thurask/btt_ups_24v_redux/btt_24v_ups_redux.kicad_pcb

## KiCad design btt_24v_ups_redux.kicad_pcb (2025-05-02)

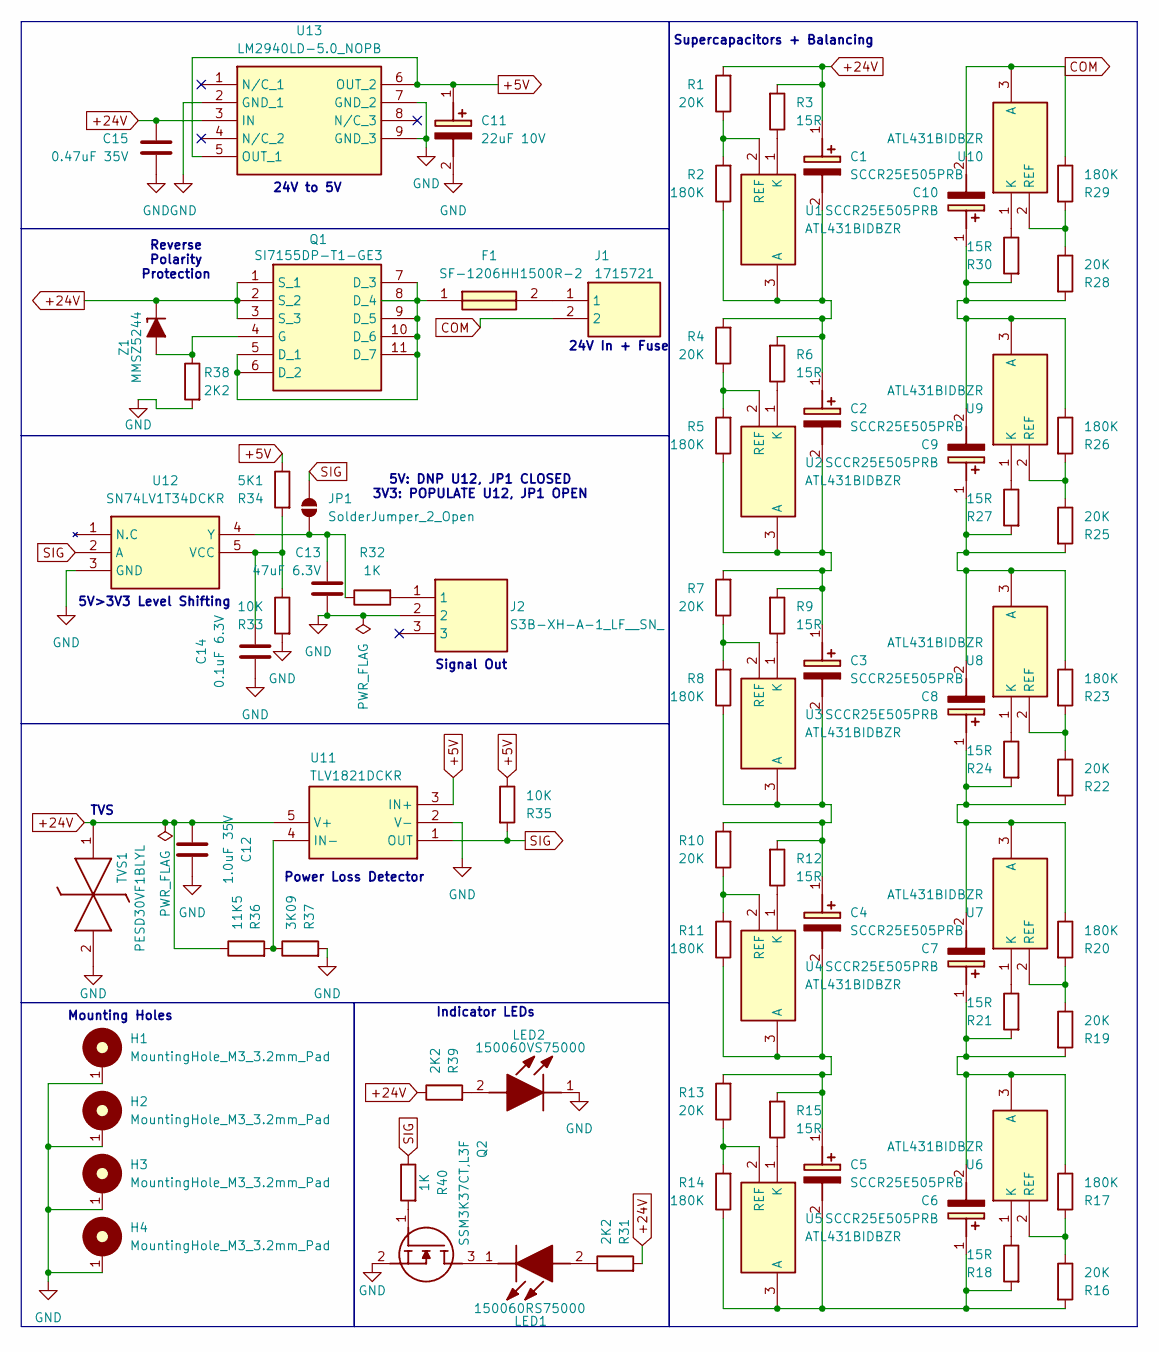
[picture p1: schematic btt_24v_ups_redux.kicad_sch]

Parts:
C1, C2, C3, C4, C5, C6, C7, C8, C9, C10: SCCR25E505PRB; CAPPRD350W65D800H2650; Mouser Part Number 581-SCCR25E505PRB
C11: 22uF 10V; T529P; Mouser Part Number 80-T529P226M10AAE200
C12: 1.0uF 35V; C_0603_1608Metric
C13: 47uF 6.3V; C_0603_1608Metric
C14: 0.1uF 6.3V; C_0603_1608Metric
C15: 0.47uF 35V; C_0603_1608Metric
F1: SF-1206HH1500R-2; SF1206HH1500R2; Mouser Part Number 652-SF-1206HH1500R-2
H1, H2, H3, H4: MountingHole_M3_3.2mm_Pad; MountingHole_3.2mm_Pad
J1: 1715721; Mouser Part Number 651-1715721
J2: S3B-XH-A-1_LF__SN_; SHDRRA3W64P0X250_1X3_990X1150X610P; Manufacturer_Part_Number S3B-XH-A-1(LF)(SN)
JP1: SolderJumper_2_Open; SolderJumper-2_P1.3mm_Open_TrianglePad1.0x1.5mm
LED1: 150060RS75000; LEDC1608X80N; Mouser Part Number 710-150060RS75000
LED2: 150060VS75000; LEDC1608X80N; Mouser Part Number 710-150060VS75000
Q1: SI7155DP-T1-GE3; SI7155DPT1GE3; Mouser Part Number 78-SISH101DN-T1-GE3
Q2: SSM3K37CT,L3F; SOT50P160X90-3N; Manufacturer_Part_Number DMN313DLT-7
R1, R4, R7, R10, R13, R16, R19, R22, R25, R28: 20K; R_0805_2012Metric
R2, R5, R8, R11, R14, R17, R20, R23, R26, R29: 180K; R_0805_2012Metric
R3, R6, R9, R12, R15, R18, R21, R24, R27, R30: 15R; R_0805_2012Metric
R31, R38, R39: 2K2; R_0603_1608Metric
R32, R40: 1K; R_0603_1608Metric
R33, R35: 10K; R_0603_1608Metric
R34: 5K1; R_0603_1608Metric
R36: 11K5; R_0603_1608Metric
R37: 3K09; R_0603_1608Metric
TVS1: PESD30VF1BLYL; PESD5V0S1BL315; Manufacturer_Part_Number PESD30VF1BLYL
U1, U2, U3, U4, U5, U6, U7, U8, U9, U10: ATL431BIDBZR; SOT95P237X112-3N; Mouser Part Number 595-ATL431BIDBZR
U11: TLV1821DCKR; SOT65P210X110-5N; Mouser Part Number 595-TLV1821DCKR
U12: SN74LV1T34DCKR; SOT65P210X110-5N; Mouser Part Number 595-SN74LV1T34DCKR
U13: LM2940LD-5.0_NOPB; LM2940LD50NOPB; Mouser Part Number 926-LM2940LD50NOPB
Z1: MMSZ5244; D_SOD-123; Manufacturer_Part_Number YFZVFHTR10B

Connections:
+5V: C11.1 (+), R34.2, R35.2, U11.3 (IN+), U13.5 (OUT_1), U13.6 (OUT_2)
+24V: C1.1 (+), C12.1, C15.1, Q1.1 (S_1), Q1.2 (S_2), Q1.3 (S_3), R1.1, R3.1, R31.1, R36.2, R39.2, TVS1.1 (K1), U11.5 (V+), U13.3 (IN), Z1.1 (K)
COM: C10.2 (-), J1.2, R29.2, U10.3 (A)
GND: C11.2 (-), C12.2, C13.2, C14.2, C15.2, H1.1, H2.1, H3.1, H4.1, J2.2, LED2.1 (K), Q2.2 (S), R33.1, R37.1, R38.1, TVS1.2 (K2), U11.2 (V-), U12.3 (GND), U13.2 (GND_1), U13.7 (GND_2), U13.9 (GND_3)
unnamed: C1.2 (-), C2.1 (+), R2.2, R4.1, R6.1, U1.3 (A)
unnamed: C2.2 (-), C3.1 (+), R5.2, R7.1, R9.1, U2.3 (A)
unnamed: C3.2 (-), C4.1 (+), R8.2, R10.1, R12.1, U3.3 (A)
unnamed: C4.2 (-), C5.1 (+), R11.2, R13.1, R15.1, U4.3 (A)
unnamed: C5.2 (-), C6.1 (+), R14.2, R16.1, R18.1, U5.3 (A)
unnamed: C6.2 (-), C7.1 (+), R17.2, R19.1, R21.1, U6.3 (A)
unnamed: C7.2 (-), C8.1 (+), R20.2, R22.1, R24.1, U7.3 (A)
unnamed: C8.2 (-), C9.1 (+), R23.2, R25.1, R27.1, U8.3 (A)
unnamed: C9.2 (-), C10.1 (+), R26.2, R28.1, R30.1, U9.3 (A)
unnamed: F1.2, J1.1
unnamed: J2.1, R32.1
unnamed: C13.1, JP1.2 (B), R32.2, U12.4 (Y)
unnamed: LED1.2 (A), R31.2
unnamed: LED1.1 (K), Q2.3 (D)
unnamed: LED2.2 (A), R39.1
unnamed: F1.1, Q1.5 (D_1), Q1.6 (D_2), Q1.7 (D_3), Q1.8 (D_4), Q1.9 (D_5), Q1.10 (D_6), Q1.11 (D_7)
unnamed: Q1.4 (G), R38.2, Z1.2 (A)
unnamed: Q2.1 (G), R40.1
unnamed: R3.2, U1.1 (K)
unnamed: R1.2, R2.1, U1.2 (REF)
unnamed: R6.2, U2.1 (K)
unnamed: R4.2, R5.1, U2.2 (REF)
unnamed: R9.2, U3.1 (K)
unnamed: R7.2, R8.1, U3.2 (REF)
unnamed: R12.2, U4.1 (K)
unnamed: R10.2, R11.1, U4.2 (REF)
unnamed: R15.2, U5.1 (K)
unnamed: R13.2, R14.1, U5.2 (REF)
unnamed: R18.2, U6.1 (K)
unnamed: R16.2, R17.1, U6.2 (REF)
unnamed: R21.2, U7.1 (K)
unnamed: R19.2, R20.1, U7.2 (REF)
unnamed: R24.2, U8.1 (K)
unnamed: R22.2, R23.1, U8.2 (REF)
unnamed: R27.2, U9.1 (K)
unnamed: R25.2, R26.1, U9.2 (REF)
unnamed: R30.2, U10.1 (K)
unnamed: R28.2, R29.1, U10.2 (REF)
unnamed: R36.1, R37.2, U11.4 (IN-)
unnamed: C14.1, R33.2, R34.1, U12.5 (VCC)
SIG: JP1.1 (A), R35.1, R40.2, U11.1 (OUT), U12.2 (A)

Notes on the sheet:
Supercapacitors + Balancing
Signal Out
Indicator LEDs
5V: DNP U12, JP1 CLOSED 3V3: POPULATE U12, JP1 OPEN
Mounting Holes
5V>3V3 Level Shifting
24V In + Fuse
Reverse Polarity Protection
Power Loss Detector
TVS
24V to 5V

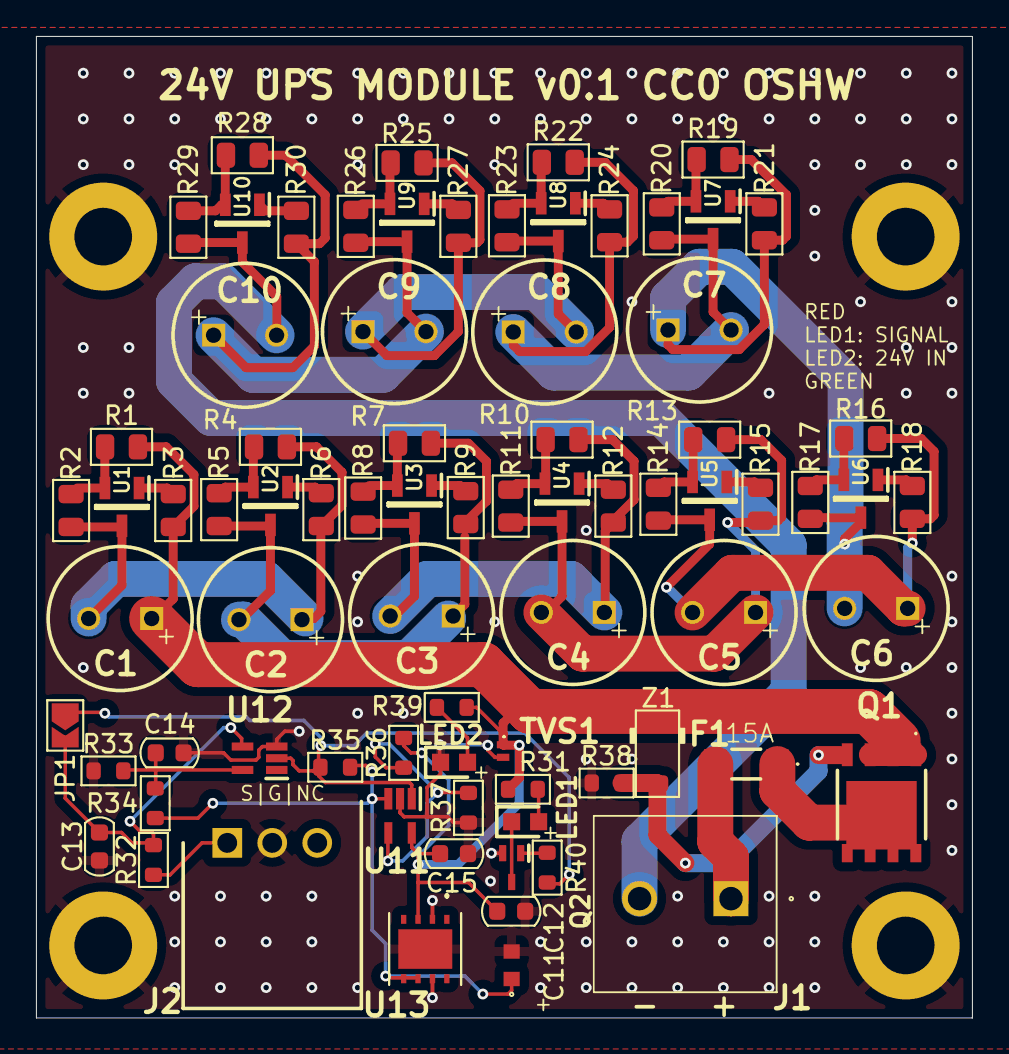
[picture p2: board btt_24v_ups_redux.kicad_pcb from above]

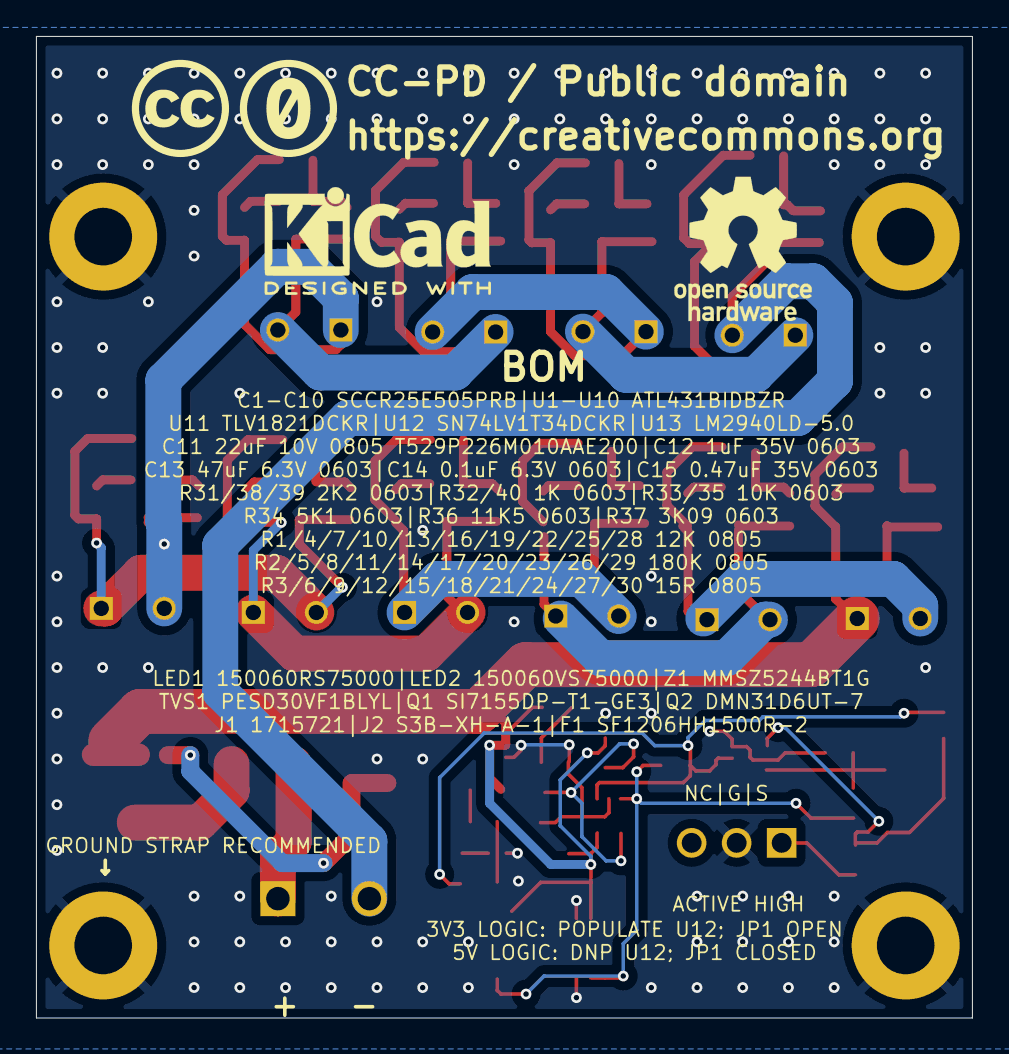
[picture p3: board btt_24v_ups_redux.kicad_pcb from below]

Board: 2 copper layers, 52.0 x 54.5 mm, 85 parts (3 on the bottom side), 45 nets.

Other parts of the board:
L01: OSHW-Logo_7.5x8mm_SilkScreen
L02: Symbol_CreativeCommonsPublicDomain_SilkScreenTop_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; Symbol_CreativeCommonsPublicDomain_SilkScreenTop_Small
L03: KiCad-Logo2_5mm_SilkScreen
