thurask/btt_ups_24v_redux/(notices)

Notices in the files:
btt_24v_ups_redux.kicad_pcb:
24V UPS MODULE v0.1 CC0 OSHW
parts and their libraries:
CC-PD / Public domain
